VinFar/SML_Reader_V2.0/ConsumerUnit.jpg

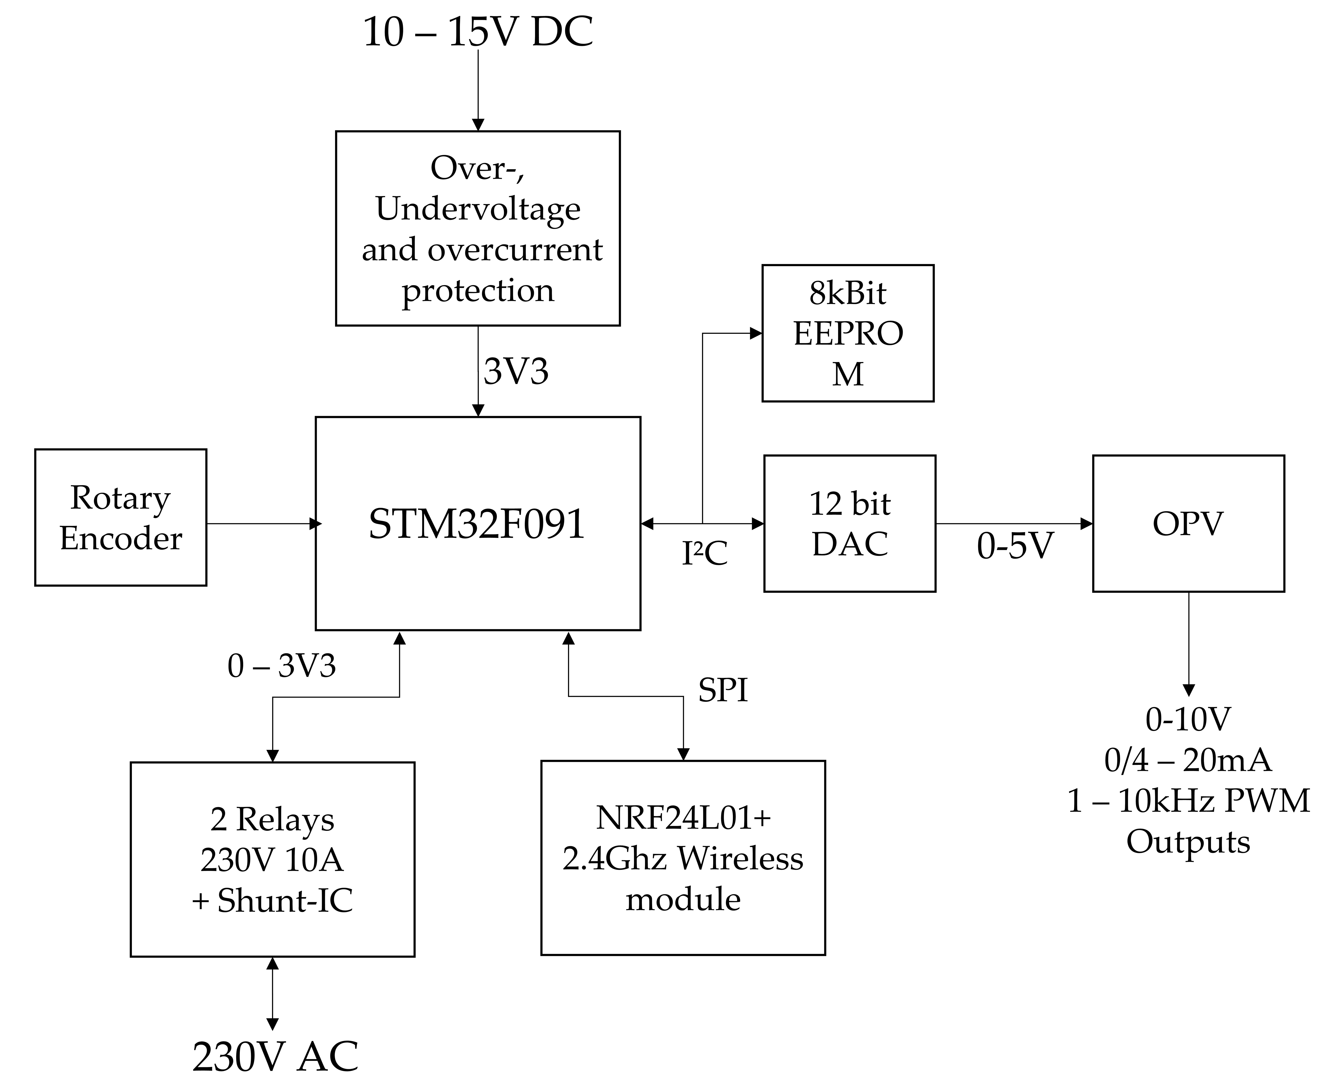
ConsumerUnit.jpg
