VinFar/SML_Reader_V2.0/InventorRenderingDisplay.png

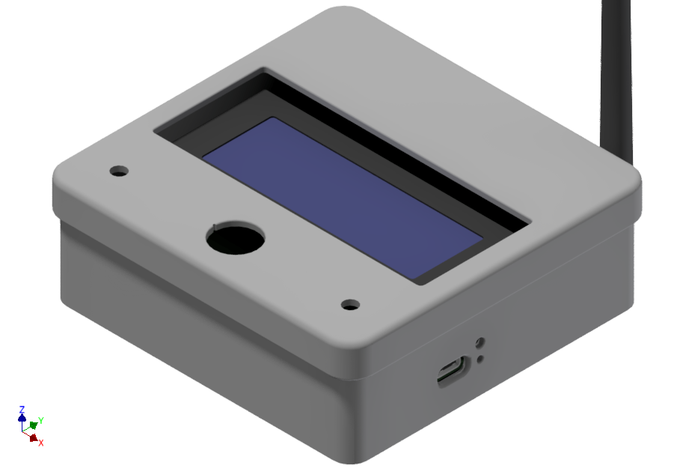
InventorRenderingDisplay.png
