VinFar/SML_Reader_V2.0/MATLAB/1503020_12h.png

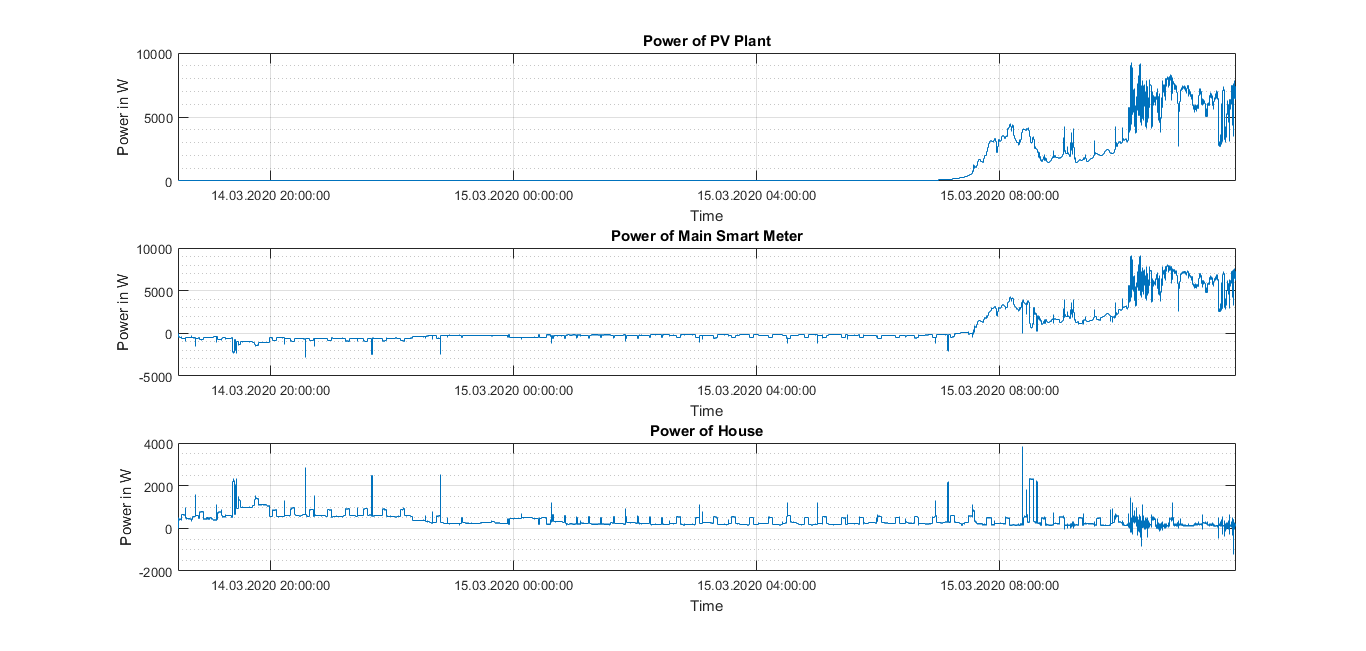
MATLAB/1503020_12h.png
