VinFar/SML_Reader_V2.0/OverviewHardware.png

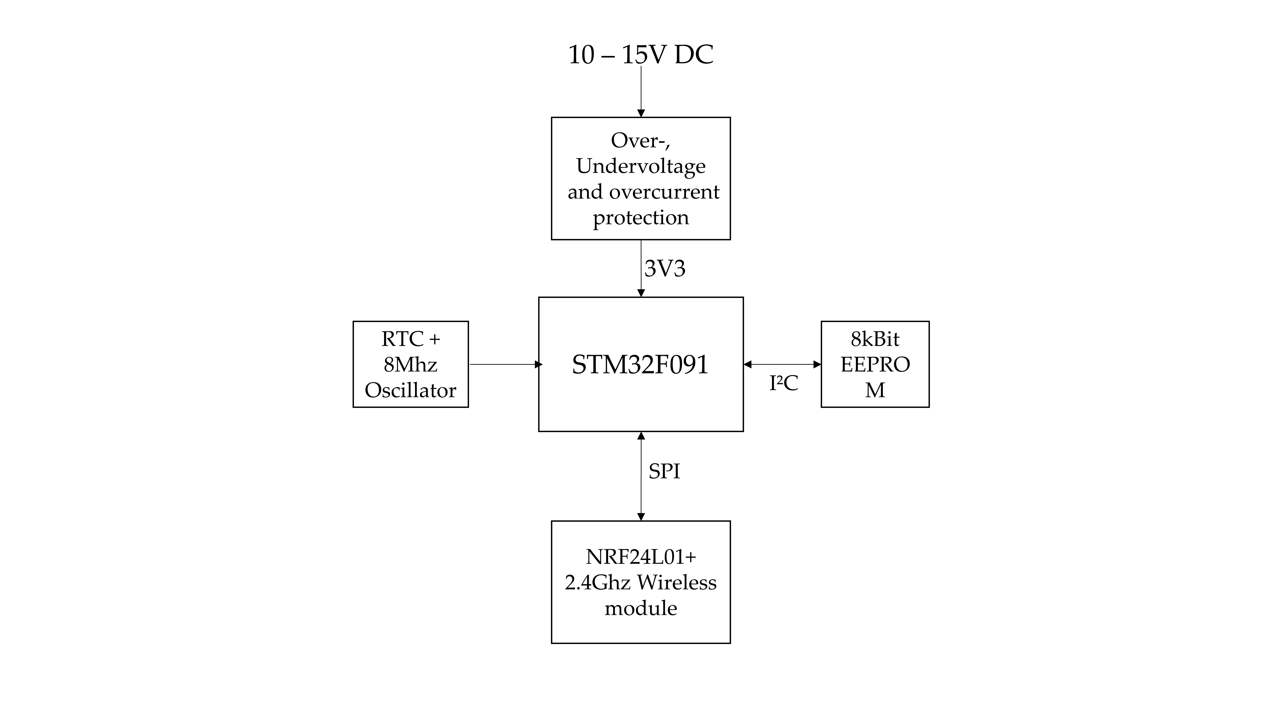
OverviewHardware.png
