VinFar/SML_Reader_V2.0/(threads)

Thread 1 (2020-03-31):

LC Display out of sync with I²C Master

VinFar, 2020-03-31:
After some time, the LCD displays garbarge and can only be reset with a system reset.
May be caused by the SPI communication
