VinFar/SML_Reader_V2.0/inc/nrf24.h

#ifndef __NRF24_H
#define __NRF24_H


// Low level functions (hardware depended)
#include "nrf24_hal.h"
#include "usart.h"
#include "shared_defines.h"


#ifndef nRF24_ADDR_REVERSE
// How the TX/RX address should be transmitted to the transceiver
//   0 - straight - the first byte of the address transmitted first
//   1 - reverse - the last byte of the address transmitted first
#define nRF24_ADDR_REVERSE         0
#endif
// Timeout counter (depends on the CPU speed)
// Used for not stuck waiting for IRQ
#define nRF24_WAIT_TIMEOUT         (uint32_t)0x000FFFFF

// nRF24L0 instruction definitions
#define nRF24_CMD_R_REGISTER       (uint8_t)0x00 // Register read
#define nRF24_CMD_W_REGISTER       (uint8_t)0x20 // Register write
#define nRF24_CMD_R_RX_PAYLOAD     (uint8_t)0x61 // Read RX payload
#define nRF24_CMD_W_TX_PAYLOAD     (uint8_t)0xA0 // Write TX payload
#define nRF24_CMD_FLUSH_TX         (uint8_t)0xE1 // Flush TX FIFO
#define nRF24_CMD_FLUSH_RX         (uint8_t)0xE2 // Flush RX FIFO
#define nRF24_CMD_REUSE_TX_PL      (uint8_t)0xE3 // Reuse TX payload
#define nRF24_CMD_LOCK_UNLOCK      (uint8_t)0x50 // Lock/unlock exclusive features
#define nRF24_CMD_NOP              (uint8_t)0xFF // No operation (used for reading status register)

// nRF24L0 register definitions
#define nRF24_REG_CONFIG           (uint8_t)0x00 // Configuration register
#define nRF24_REG_EN_AA            (uint8_t)0x01 // Enable "Auto acknowledgment"
#define nRF24_REG_EN_RXADDR        (uint8_t)0x02 // Enable RX addresses
#define nRF24_REG_SETUP_AW         (uint8_t)0x03 // Setup of address widths
#define nRF24_REG_SETUP_RETR       (uint8_t)0x04 // Setup of automatic retransmit
#define nRF24_REG_RF_CH            (uint8_t)0x05 // RF channel
#define nRF24_REG_RF_SETUP         (uint8_t)0x06 // RF setup register
#define nRF24_REG_STATUS           (uint8_t)0x07 // Status register
#define nRF24_REG_OBSERVE_TX       (uint8_t)0x08 // Transmit observe register
#define nRF24_REG_RPD              (uint8_t)0x09 // Received power detector
#define nRF24_REG_RX_ADDR_P0       (uint8_t)0x0A // Receive address data pipe 0
#define nRF24_REG_RX_ADDR_P1       (uint8_t)0x0B // Receive address data pipe 1
#define nRF24_REG_RX_ADDR_P2       (uint8_t)0x0C // Receive address data pipe 2
#define nRF24_REG_RX_ADDR_P3       (uint8_t)0x0D // Receive address data pipe 3
#define nRF24_REG_RX_ADDR_P4       (uint8_t)0x0E // Receive address data pipe 4
#define nRF24_REG_RX_ADDR_P5       (uint8_t)0x0F // Receive address data pipe 5
#define nRF24_REG_TX_ADDR          (uint8_t)0x10 // Transmit address
#define nRF24_REG_RX_PW_P0         (uint8_t)0x11 // Number of bytes in RX payload in data pipe 0
#define nRF24_REG_RX_PW_P1         (uint8_t)0x12 // Number of bytes in RX payload in data pipe 1
#define nRF24_REG_RX_PW_P2         (uint8_t)0x13 // Number of bytes in RX payload in data pipe 2
#define nRF24_REG_RX_PW_P3         (uint8_t)0x14 // Number of bytes in RX payload in data pipe 3
#define nRF24_REG_RX_PW_P4         (uint8_t)0x15 // Number of bytes in RX payload in data pipe 4
#define nRF24_REG_RX_PW_P5         (uint8_t)0x16 // Number of bytes in RX payload in data pipe 5
#define nRF24_REG_FIFO_STATUS      (uint8_t)0x17 // FIFO status register
#define nRF24_REG_DYNPD            (uint8_t)0x1C // Enable dynamic payload length
#define nRF24_REG_FEATURE          (uint8_t)0x1D // Feature register

// Register bits definitions
#define nRF24_CONFIG_PRIM_RX       (uint8_t)0x01 // PRIM_RX bit in CONFIG register
#define nRF24_CONFIG_PWR_UP        (uint8_t)0x02 // PWR_UP bit in CONFIG register
#define nRF24_FLAG_RX_DR           (uint8_t)0x40 // RX_DR bit (data ready RX FIFO interrupt)
#define nRF24_FLAG_TX_DS           (uint8_t)0x20 // TX_DS bit (data sent TX FIFO interrupt)
#define nRF24_FLAG_MAX_RT          (uint8_t)0x10 // MAX_RT bit (maximum number of TX retransmits interrupt)

// Register masks definitions
#define nRF24_MASK_REG_MAP         (uint8_t)0x1F // Mask bits[4:0] for CMD_RREG and CMD_WREG commands
#define nRF24_MASK_CRC             (uint8_t)0x0C // Mask for CRC bits [3:2] in CONFIG register
#define nRF24_MASK_STATUS_IRQ      (uint8_t)0x70 // Mask for all IRQ bits in STATUS register
#define nRF24_MASK_RF_PWR          (uint8_t)0x06 // Mask RF_PWR[2:1] bits in RF_SETUP register
#define nRF24_MASK_RX_P_NO         (uint8_t)0x0E // Mask RX_P_NO[3:1] bits in STATUS register
#define nRF24_MASK_DATARATE        (uint8_t)0x28 // Mask RD_DR_[5,3] bits in RF_SETUP register
#define nRF24_MASK_EN_RX           (uint8_t)0x3F // Mask ERX_P[5:0] bits in EN_RXADDR register
#define nRF24_MASK_RX_PW           (uint8_t)0x3F // Mask [5:0] bits in RX_PW_Px register
#define nRF24_MASK_RETR_ARD        (uint8_t)0xF0 // Mask for ARD[7:4] bits in SETUP_RETR register
#define nRF24_MASK_RETR_ARC        (uint8_t)0x0F // Mask for ARC[3:0] bits in SETUP_RETR register
#define nRF24_MASK_RXFIFO          (uint8_t)0x03 // Mask for RX FIFO status bits [1:0] in FIFO_STATUS register
#define nRF24_MASK_TXFIFO          (uint8_t)0x30 // Mask for TX FIFO status bits [5:4] in FIFO_STATUS register
#define nRF24_MASK_PLOS_CNT        (uint8_t)0xF0 // Mask for PLOS_CNT[7:4] bits in OBSERVE_TX register
#define nRF24_MASK_ARC_CNT         (uint8_t)0x0F // Mask for ARC_CNT[3:0] bits in OBSERVE_TX register
#define nRF24_MASK_SETUP_AW        (uint8_t)0x03 // Mask for AW[1:0] bits in SETUP_AW register


// Retransmit delay
typedef enum {
	nRF24_ARD_NONE   = (uint8_t)0x00, // Dummy value for case when retransmission is not used
	nRF24_ARD_250us  = (uint8_t)0x00,
	nRF24_ARD_500us  = (uint8_t)0x01,
	nRF24_ARD_750us  = (uint8_t)0x02,
	nRF24_ARD_1000us = (uint8_t)0x03,
	nRF24_ARD_1250us = (uint8_t)0x04,
	nRF24_ARD_1500us = (uint8_t)0x05,
	nRF24_ARD_1750us = (uint8_t)0x06,
	nRF24_ARD_2000us = (uint8_t)0x07,
	nRF24_ARD_2250us = (uint8_t)0x08,
	nRF24_ARD_2500us = (uint8_t)0x09,
	nRF24_ARD_2750us = (uint8_t)0x0A,
	nRF24_ARD_3000us = (uint8_t)0x0B,
	nRF24_ARD_3250us = (uint8_t)0x0C,
	nRF24_ARD_3500us = (uint8_t)0x0D,
	nRF24_ARD_3750us = (uint8_t)0x0E,
	nRF24_ARD_4000us = (uint8_t)0x0F
}nrf24_ard_delays_t;


// RF output power in TX mode
typedef enum {
	nRF24_TXPWR_18dBm = (uint8_t)0x00, // -18dBm
	nRF24_TXPWR_12dBm = (uint8_t)0x02, // -12dBm
	nRF24_TXPWR_6dBm  = (uint8_t)0x04, //  -6dBm
	nRF24_TXPWR_0dBm  = (uint8_t)0x06  //   0dBm
}nrf24_txpwr_t;



// nRF24L01 power control
typedef enum {
	nRF24_PWR_UP   = (uint8_t)0x02, // Power up
	nRF24_PWR_DOWN = (uint8_t)0x00  // Power down
}nrf24_pwr_mode_t;

// Transceiver mode
typedef enum {
	nRF24_MODE_RX = (uint8_t)0x01, // PRX
	nRF24_MODE_TX = (uint8_t)0x00  // PTX
}nrf24_mode_t;



// State of auto acknowledgment for specified pipe
typedef enum {
	nRF24_AA_OFF = (uint8_t)0x00,
	nRF24_AA_ON  = (uint8_t)0x01
}nrf24_aa_t;

// Status of the RX FIFO
enum {
	nRF24_STATUS_RXFIFO_DATA  = (uint8_t)0x00, // The RX FIFO contains data and available locations
	nRF24_STATUS_RXFIFO_EMPTY = (uint8_t)0x01, // The RX FIFO is empty
	nRF24_STATUS_RXFIFO_FULL  = (uint8_t)0x02, // The RX FIFO is full
	nRF24_STATUS_RXFIFO_ERROR = (uint8_t)0x03  // Impossible state: RX FIFO cannot be empty and full at the same time
};

// Status of the TX FIFO
enum {
	nRF24_STATUS_TXFIFO_DATA  = (uint8_t)0x00, // The TX FIFO contains data and available locations
	nRF24_STATUS_TXFIFO_EMPTY = (uint8_t)0x01, // The TX FIFO is empty
	nRF24_STATUS_TXFIFO_FULL  = (uint8_t)0x02, // The TX FIFO is full
	nRF24_STATUS_TXFIFO_ERROR = (uint8_t)0x03  // Impossible state: TX FIFO cannot be empty and full at the same time
};

// Result of RX FIFO reading
typedef enum {
	nRF24_RX_PIPE0  = (uint8_t)0x00, // Packet received from the PIPE#0
	nRF24_RX_PIPE1  = (uint8_t)0x01, // Packet received from the PIPE#1
	nRF24_RX_PIPE2  = (uint8_t)0x02, // Packet received from the PIPE#2
	nRF24_RX_PIPE3  = (uint8_t)0x03, // Packet received from the PIPE#3
	nRF24_RX_PIPE4  = (uint8_t)0x04, // Packet received from the PIPE#4
	nRF24_RX_PIPE5  = (uint8_t)0x05, // Packet received from the PIPE#5
	nRF24_RX_EMPTY  = (uint8_t)0xff  // The RX FIFO is empty
} nRF24_RXResult;

// Result of packet transmission
typedef enum {
	nRF24_TX_ERROR = (uint8_t) 0x00, // Unknown error
	nRF24_TX_SUCCESS,                // Packet has been transmitted successfully
	nRF24_TX_TIMEOUT,                // It was timeout during packet transmit
	nRF24_TX_MAXRT         // Transmit failed with maximum auto retransmit count
} nRF24_TXResult;

typedef enum{
	nrf24_addr_width_3 = 3,
	nrf24_addr_width_4,
	nrf24_addr_width_5
}nrf24_addr_width_t;

typedef enum{
	nrf24_rx_pipe0=0,
	nrf24_rx_pipe1,
	nrf24_rx_pipe2,
	nrf24_rx_pipe3,
	nrf24_rx_pipe4,
	nrf24_rx_pipe5,
}nrf24_rx_pipes_t;

typedef enum{
	nrf_irq_rx_dr=1<<6,
	nrf_irq_tx_ds=1<<5,
	nrf_irq_max_rt=1<<4
}nrf_irq_t;



extern const uint8_t nrf24_tx_size;
extern data_union_t nrf24_tx_buf[(NRF24_TX_SIZE/4)];


// Function prototypes
void nRF24_Init(void);
uint8_t nRF24_Check(void);

void nRF24_SetPowerMode(nrf24_pwr_mode_t mode);
void nRF24_SetOperationalMode(uint8_t mode);
void nRF24_SetRFChannel(uint8_t channel);
void nRF24_SetAutoRetr(nrf24_ard_delays_t ard, uint8_t arc);
void nRF24_SetAddrWidth(nrf24_addr_width_t addr_width);
void nRF24_SetAddr(uint8_t pipe, const uint8_t *addr);
void nRF24_SetTXPower(nrf24_txpwr_t tx_pwr);
void nRF24_SetDataRate(nrf24_datarates_t data_rate);
void nRF24_SetCRCScheme(uint8_t scheme);
void nRF24_SetRXPipe(nrf24_rx_pipes_t pipe, nrf24_aa_t aa_state, uint8_t payload_len);
void nRF24_ClosePipe(uint8_t pipe);
void nRF24_EnableAA(uint8_t pipe);
void nRF24_DisableAA(uint8_t pipe);

void nrf24_powerdown();
void nrf24_powerup();

void nrf24_set_mode_rx();
void nrf24_set_mode_tx();

void nrf24_set_crc_scheme_1byte();
void nrf24_set_crc_scheme_2byte();
void nrf24_set_crc_scheme_off();

void nrf24_enable_ShockBurst(nrf24_rx_pipes_t pipe);
void nrf24_disable_ShockBurst(nrf24_rx_pipes_t pipe);


uint8_t nRF24_GetAddrWidth(void);
uint8_t nRF24_GetStatus(void);
uint8_t nRF24_GetIRQFlags(void);
uint8_t nRF24_GetStatus_RXFIFO(void);
uint8_t nRF24_GetStatus_TXFIFO(void);
uint8_t nRF24_GetRXSource(void);
uint8_t nRF24_GetRetransmitCounters(void);

void nRF24_ResetPLOS(void);
void nRF24_FlushTX(void);
void nRF24_FlushRX(void);
void nRF24_ClearIRQFlags(void);

void nrf24_init_tx();
void nrf24_init_rx(nrf24_pipes_t pipe, uint32_t addr);
void nrf24_init_gen();

void nRF24_WritePayload(uint8_t *pBuf, uint8_t length);
nRF24_RXResult nRF24_ReadPayload(uint8_t *pBuf, uint8_t *length);
nRF24_TXResult nRF24_TransmitPacket(uint8_t *pBuf, uint8_t length);
int8_t nrf_add_qeue(uint8_t cmd, data_union_t *ptr, uint32_t addr,nrf24_pipes_t pipe);
int8_t nrf_transmit_next_item();
void nrf_enable_irq(nrf_irq_t irq);
void nrf_disable_irq(nrf_irq_t irq);

#endif // __NRF24_H
