VinFar/SML_Reader_V2.0/src/gpio.c

#include "main.h"
#include "stm32f0xx_hal_gpio.h"
#include "gpio.h"
#include "nrf24_hal.h"

void gpio_init(void) {

	GPIO_InitTypeDef GPIO_InitStruct = { 0 };

	/* GPIO Ports Clock Enable */
	__HAL_RCC_GPIOC_CLK_ENABLE()
	;
	__HAL_RCC_GPIOF_CLK_ENABLE()
	;
	__HAL_RCC_GPIOA_CLK_ENABLE()
	;
	__HAL_RCC_GPIOB_CLK_ENABLE()
	;
	__HAL_RCC_GPIOD_CLK_ENABLE()
	;

	/*Configure GPIO pin Output Level */
	HAL_GPIO_WritePin(GPIOB, LED1_Pin | LED2_Pin | LED3_Pin, GPIO_PIN_RESET);

	/*Configure GPIO pin Output Level */
	HAL_GPIO_WritePin(GPIOC, FLASH_CS_Pin | NRF_CE_Pin, GPIO_PIN_RESET);

	/*Configure GPIO pin Output Level */
	GPIO_InitStruct.Pin = USART3_RX_Pin;
	GPIO_InitStruct.Mode = GPIO_MODE_AF_PP;
	GPIO_InitStruct.Pull = GPIO_NOPULL;
	GPIO_InitStruct.Speed = GPIO_SPEED_FREQ_HIGH;
	GPIO_InitStruct.Alternate = GPIO_AF1_USART3;
	HAL_GPIO_Init(USART3_RX_GPIO_Port, &GPIO_InitStruct);

	GPIO_InitStruct.Pin = USART1_RX_Pin;
	GPIO_InitStruct.Mode = GPIO_MODE_AF_PP;
	GPIO_InitStruct.Pull = GPIO_NOPULL;
	GPIO_InitStruct.Speed = GPIO_SPEED_FREQ_HIGH;
	GPIO_InitStruct.Alternate = GPIO_AF1_USART1;
	HAL_GPIO_Init(USART1_RX_GPIO_Port, &GPIO_InitStruct);

	GPIO_InitStruct.Pin = USART6_RX_Pin | USART6_TX_Pin;
	GPIO_InitStruct.Mode = GPIO_MODE_AF_PP;
	GPIO_InitStruct.Pull = GPIO_NOPULL;
	GPIO_InitStruct.Speed = GPIO_SPEED_FREQ_HIGH;
	GPIO_InitStruct.Alternate = GPIO_AF2_USART6;
	HAL_GPIO_Init(USART6_RX_GPIO_Port, &GPIO_InitStruct);


	GPIO_InitStruct.Pin = COMP1_OUT_Pin;
	GPIO_InitStruct.Mode = GPIO_MODE_AF_PP;
	GPIO_InitStruct.Pull = GPIO_NOPULL;
	GPIO_InitStruct.Speed = GPIO_SPEED_FREQ_HIGH;
	GPIO_InitStruct.Alternate = GPIO_AF7_COMP1;
	HAL_GPIO_Init(COMP1_OUT_GPIO_Port, &GPIO_InitStruct);

	GPIO_InitStruct.Pin = COMP2_OUT_Pin;
	GPIO_InitStruct.Mode = GPIO_MODE_AF_PP;
	GPIO_InitStruct.Pull = GPIO_NOPULL;
	GPIO_InitStruct.Speed = GPIO_SPEED_FREQ_HIGH;
	GPIO_InitStruct.Alternate = GPIO_AF7_COMP2;
	HAL_GPIO_Init(COMP2_OUT_GPIO_Port, &GPIO_InitStruct);

	/*Configure GPIO pins : PBPin PBPin PBPin */
	GPIO_InitStruct.Pin = LED1_Pin | LED2_Pin | LED3_Pin;
	GPIO_InitStruct.Mode = GPIO_MODE_OUTPUT_PP;
	GPIO_InitStruct.Pull = GPIO_NOPULL;
	GPIO_InitStruct.Speed = GPIO_SPEED_FREQ_LOW;
	HAL_GPIO_Init(GPIOB, &GPIO_InitStruct);

	/*Configure GPIO pins : PCPin PCPin */
	GPIO_InitStruct.Pin = FLASH_CS_Pin;
	GPIO_InitStruct.Mode = GPIO_MODE_OUTPUT_PP;
	GPIO_InitStruct.Pull = GPIO_PULLUP;
	GPIO_InitStruct.Speed = GPIO_SPEED_FREQ_LOW;
	HAL_GPIO_Init(GPIOC, &GPIO_InitStruct);
	SPI_CS_FLASH_HIGH;

	/*Configure GPIO pin : PtPin */
	GPIO_InitStruct.Pin = NRF_IRQ_Pin;
	GPIO_InitStruct.Mode = GPIO_MODE_OUTPUT_PP;
	GPIO_InitStruct.Pull = GPIO_NOPULL;
	HAL_GPIO_Init(NRF_IRQ_GPIO_Port, &GPIO_InitStruct);

	/*Configure GPIO pin : PtPin */
	GPIO_InitStruct.Pin = SPI1_CS_NRF_Pin;
	GPIO_InitStruct.Mode = GPIO_MODE_OUTPUT_PP;
	GPIO_InitStruct.Pull = GPIO_NOPULL;
	GPIO_InitStruct.Speed = GPIO_SPEED_FREQ_LOW;
	HAL_GPIO_Init(SPI1_CS_NRF_GPIO_Port, &GPIO_InitStruct);

	/*Configure GPIO pin : PtPin */
	GPIO_InitStruct.Pin = NRF_CE_Pin;
	GPIO_InitStruct.Mode = GPIO_MODE_OUTPUT_PP;
	GPIO_InitStruct.Pull = GPIO_NOPULL;
	GPIO_InitStruct.Speed = GPIO_SPEED_FREQ_LOW;
	HAL_GPIO_Init(NRF_CE_GPIO_Port, &GPIO_InitStruct);

	nRF24_CSN_H;
	nRF24_CE_L;


	/*
	 * uncomment to output USART6 TX on IR LED of read head
	 */
//	GPIO_InitStruct.Pin = DAC_RJ2_IN_Pin;
//	GPIO_InitStruct.Mode = GPIO_MODE_AF_PP;
//	GPIO_InitStruct.Alternate = GPIO_AF5_USART6;
//	GPIO_InitStruct.Pull = GPIO_NOPULL;
//	HAL_GPIO_Init(DAC_RJ2_IN_GPIO_Port, &GPIO_InitStruct);


}
