VinFar/SML_Reader_V2.0/(commit log)

2019-12-23 add: i2c, eeprom, STM32HAL for Init
2020-01-30 Revert "sync commit"
    This reverts commit 8084e693c654123e1892da68eb2888112abc2c39.
    [functions.c, main.c]
2020-02-14 SPI Flash ID read working
2020-02-26 add: flash driver
2020-03-03 add: usart6 for host pc, CRC, cmd and ack frame
2020-03-14 add: experimental fast spi functions
2020-03-14 use of experimental spi functions in flash
2020-03-14 fast spi, RTC and unix time, data saving through compare
2020-03-14 add: time on X Axis on matlab plot
2020-03-14 fixed bug in flash_write, back to HAL_SPI, 2s save
    [flash.c, flash.h, functions.c, functions.h, main.c, rtc.c, rtc.h, usart.h]
2020-03-17 ch: DAC Voltage for better receiving
2020-03-17 cleaned up for new PCB
2020-03-21 add: timer inits
2020-04-01 refacatored, lcd not working
    [main.c, rtc.c]
2020-04-02 added fram around time, re-enabled spi
2020-04-09 changed NRF24 RX frame to newer version
2020-04-10 add: flash capacity transmit
2020-04-10 changed RTC calibration
2020-04-11 add: RX of flash capacity
2020-04-18 add: relays. left one ist not working
    [functions.c, gpio.c, gpio.h, main.h]
2020-04-19 add: relay switching, second NRF RX from display
2020-04-20 adc working
2020-04-20 removed adc cont conv
2020-04-20 add: adc
2020-04-21 changed to replace phototrans. with diode
    [comp.c]
2020-04-21 add data, fixed bug
    [functions.c]
2020-04-21 removed GPIO Init for ADC, DAC
2020-04-21 moved dac init to top, add adc init and init tx data
2020-04-21 add: periodic adc read
2020-04-21 add: printf for usart6
